nachomcapella/Upper-Limb-Rehabilitation-Interface-with-Arduino/second-version/documents-images/diagrama_electronica-v2.2.jpg

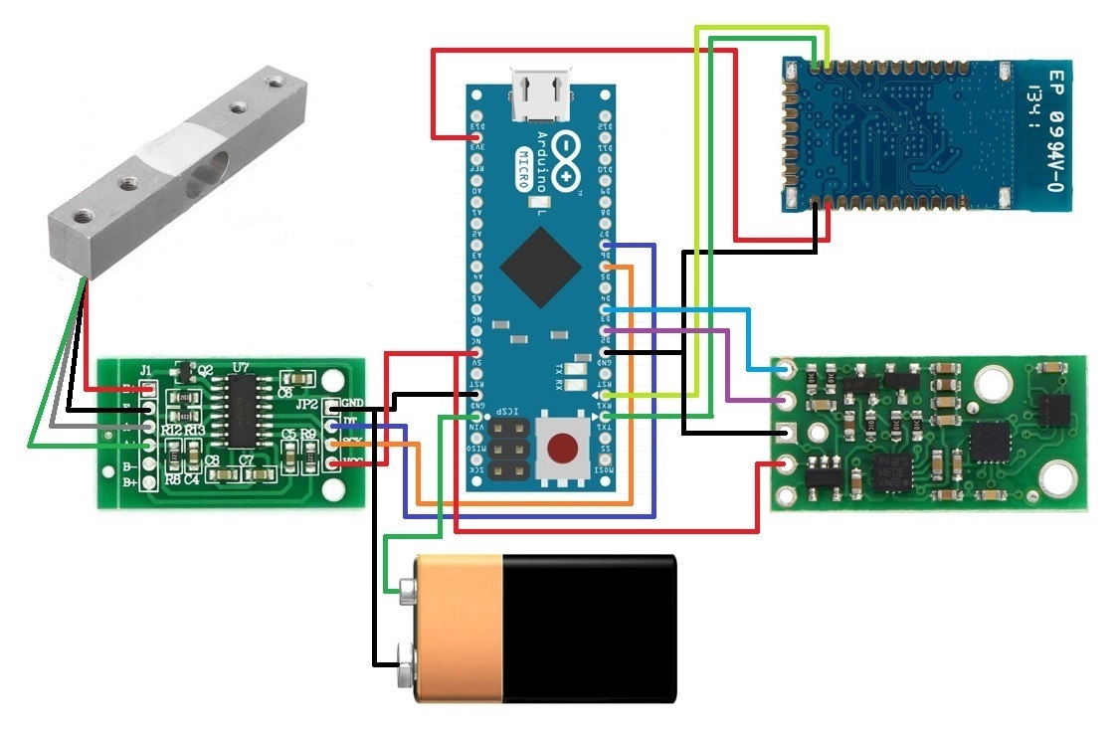
second-version/documents-images/diagrama_electronica-v2.2.jpg
