nachomcapella/Upper-Limb-Rehabilitation-Interface-with-Arduino/README.md

# upper-limb-rehabilitation-arduino
This repository includes the code employed for the construction of an interface oriented to upper limb rehabilitation. Includes Arduino code, squematics and a videogame (flash).
