nachomcapella/Upper-Limb-Rehabilitation-Interface-with-Arduino/second-version/documents-images/ArduinoMicro_Pinout.png

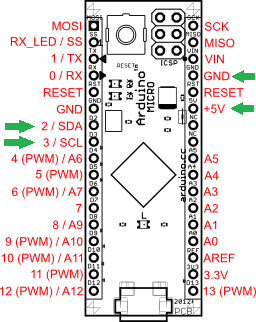
second-version/documents-images/ArduinoMicro_Pinout.png
