nachomcapella/Upper-Limb-Rehabilitation-Interface-with-Arduino/second-version/documents-images/diagrama-hx711-amplificador-arduino.jpg

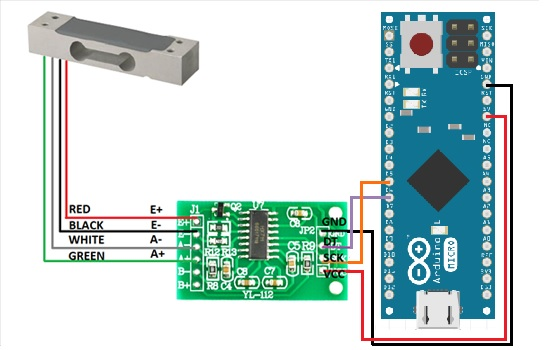
second-version/documents-images/diagrama-hx711-amplificador-arduino.jpg
