nachomcapella/Upper-Limb-Rehabilitation-Interface-with-Arduino/second-version/documents-images/diagrama_electronica_primer_modelo_bluetooth.jpg

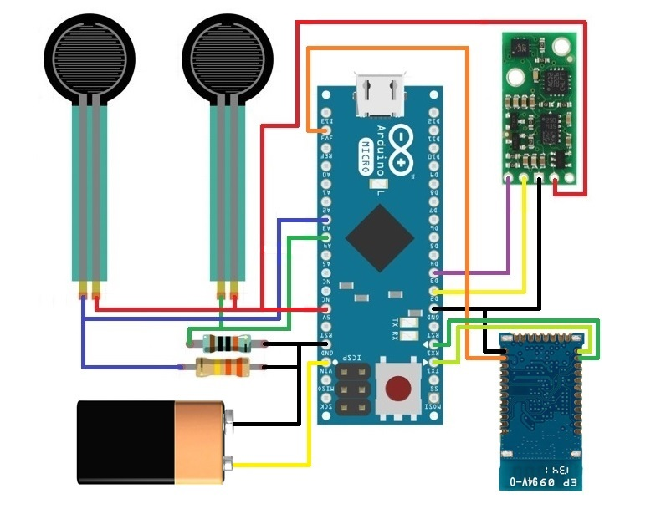
second-version/documents-images/diagrama_electronica_primer_modelo_bluetooth.jpg
