nachomcapella/Upper-Limb-Rehabilitation-Interface-with-Arduino/second-version/documents-images/interfaz-1-derecha.jpg

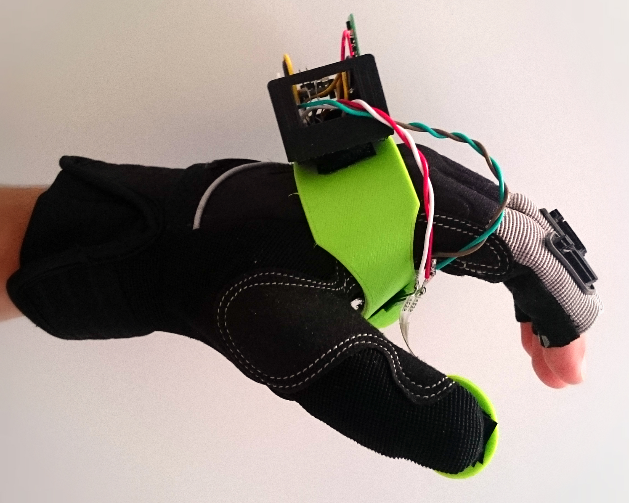
second-version/documents-images/interfaz-1-derecha.jpg
