nachomcapella/Upper-Limb-Rehabilitation-Interface-with-Arduino/second-version/documents-images/interfaz-2-frontal.jpg

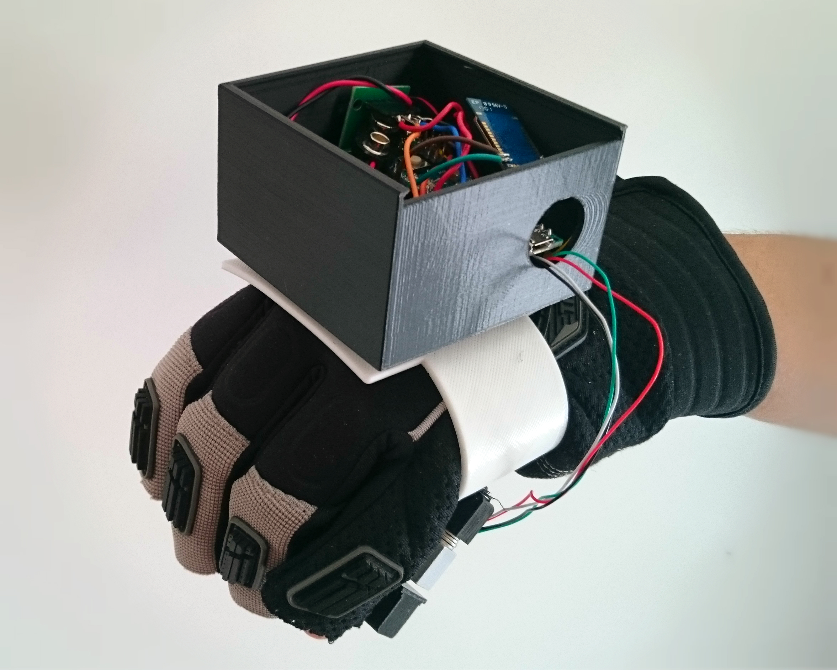
second-version/documents-images/interfaz-2-frontal.jpg
