nachomcapella/Upper-Limb-Rehabilitation-Interface-with-Arduino/second-version/documents-images/interfaz-2-inferior.jpg

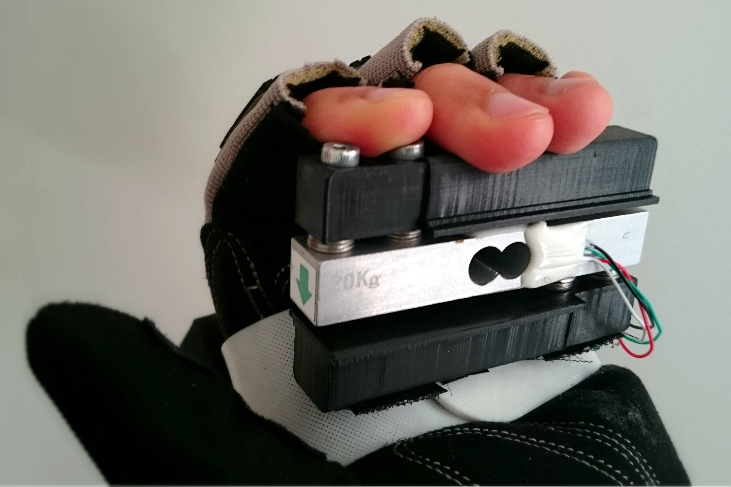
second-version/documents-images/interfaz-2-inferior.jpg
