nachomcapella/Upper-Limb-Rehabilitation-Interface-with-Arduino/second-version/documents-images/interfaz-2-izquierda.jpg

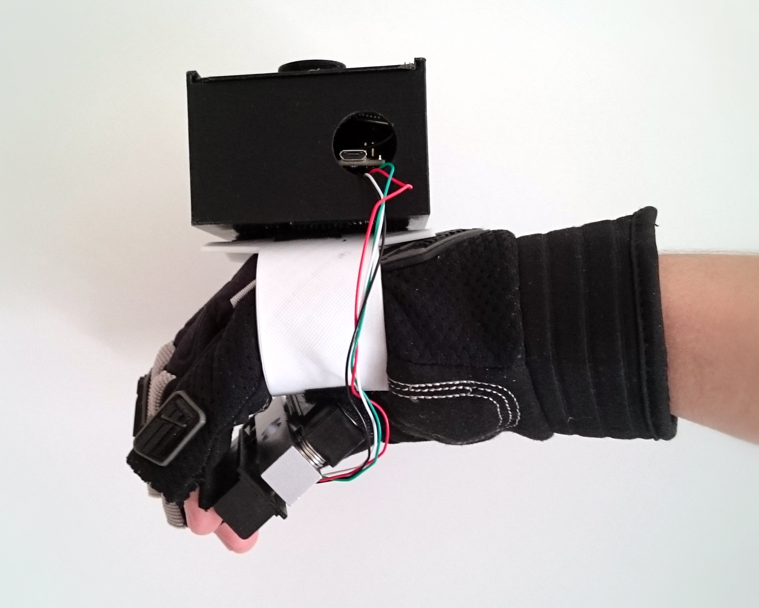
second-version/documents-images/interfaz-2-izquierda.jpg
