nachomcapella/Upper-Limb-Rehabilitation-Interface-with-Arduino/second-version/documents-images/medidas-electronica.png

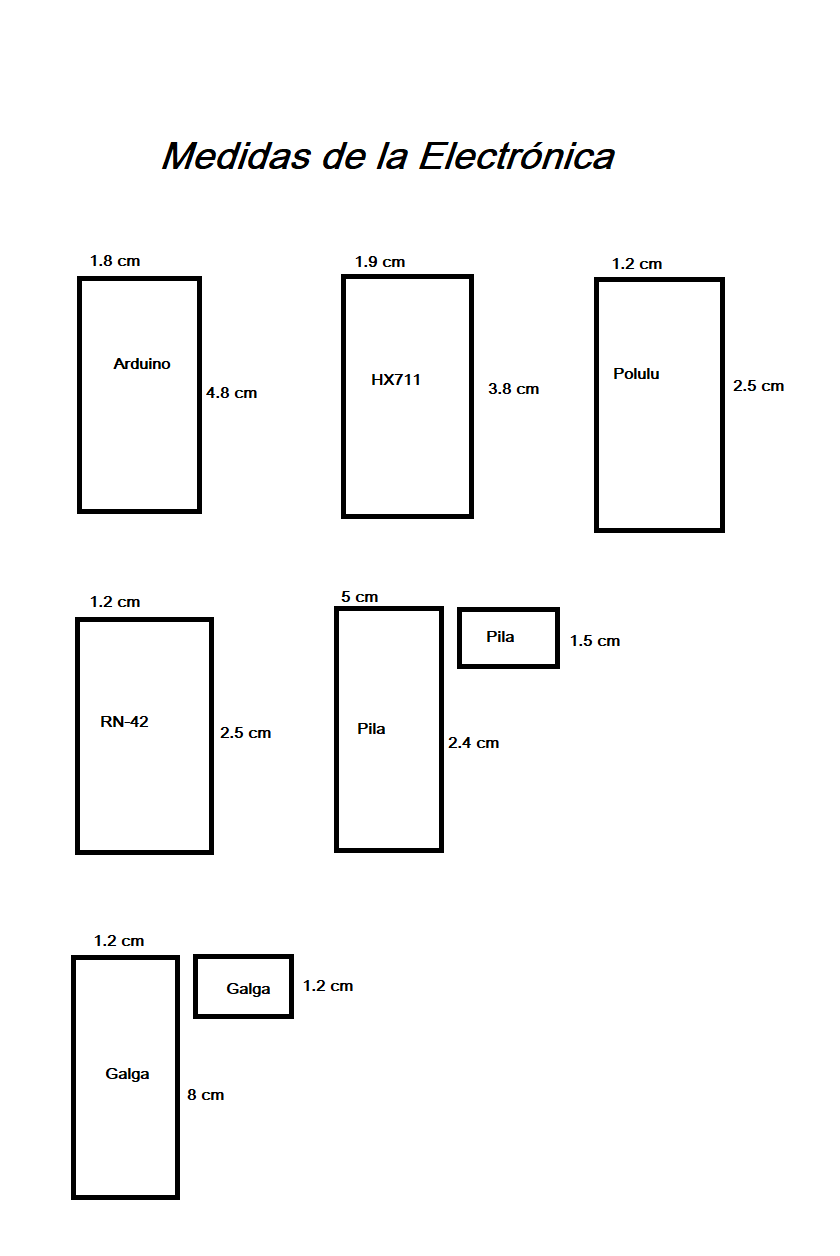
second-version/documents-images/medidas-electronica.png
