nachomcapella/Upper-Limb-Rehabilitation-Interface-with-Arduino/second-version/documents-images/monitor-serie-2.JPG

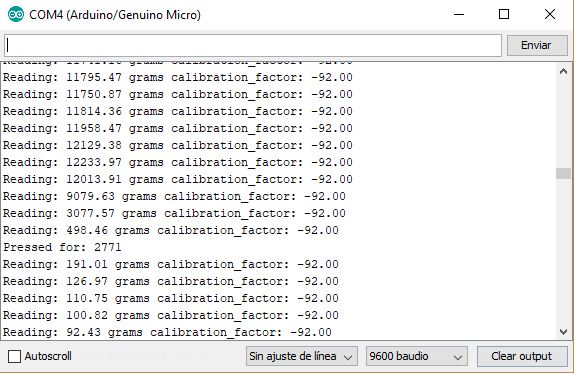
second-version/documents-images/monitor-serie-2.JPG
