nachomcapella/Upper-Limb-Rehabilitation-Interface-with-Arduino/second-version/documents-images/temperature-plot.png

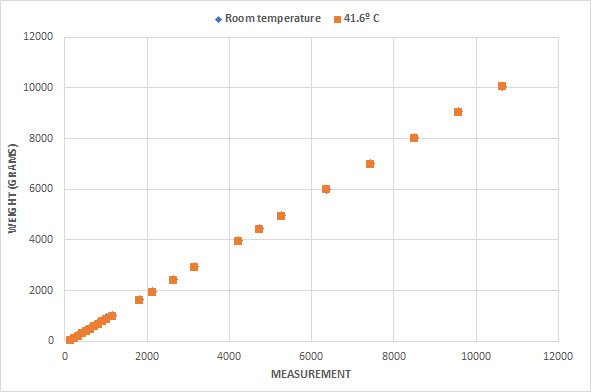
second-version/documents-images/temperature-plot.png
