nachomcapella/Upper-Limb-Rehabilitation-Interface-with-Arduino/second-version/documents-images/vista-freecad.PNG

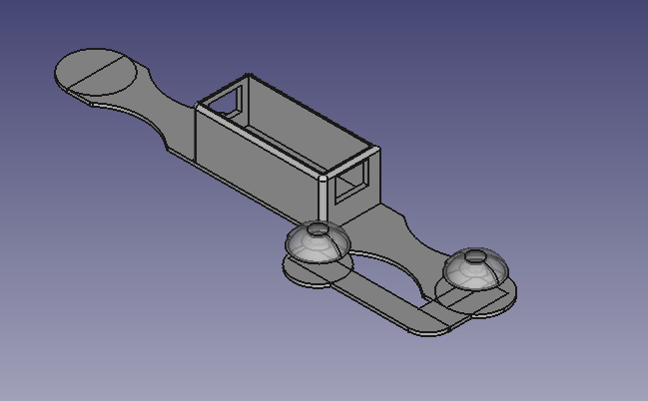
second-version/documents-images/vista-freecad.PNG
