nachomcapella/Upper-Limb-Rehabilitation-Interface-with-Arduino/3d-printing/guante.FCStd

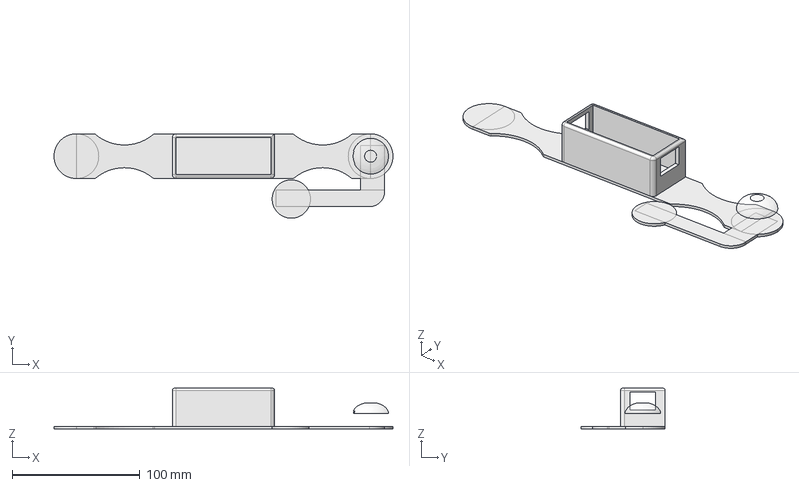
[picture p24: CAD file, 2018-01-18]
3d-printing/guante.FCStd
265.0 x 66.0 x 32.0 mm
Correa
Boton001
Caja002
Boton003
