nachomcapella/Upper-Limb-Rehabilitation-Interface-with-Arduino/second-version/3d-printing/pera3.FCStd

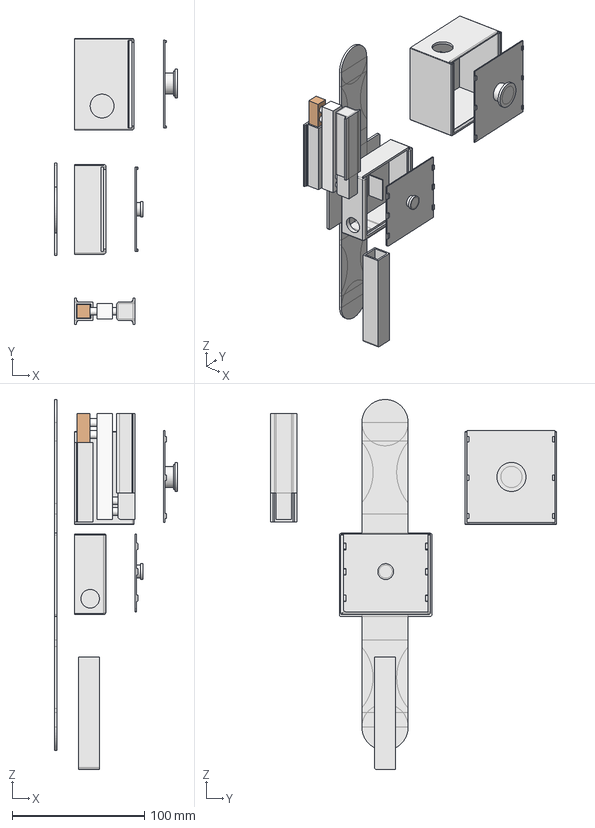
[picture p25: CAD file, 2018-07-01]
second-version/3d-printing/pera3.FCStd
93.0 x 216.0 x 279.5 mm
Cubo038
