nachomcapella/Upper-Limb-Rehabilitation-Interface-with-Arduino/second-version/documents-images/hx711-calibracion-v3.xlsx

Arroz (gr) | Medida | Factor de corrección | Factor de corrección | Masa | Medida (T ambiente) | Medida (41.6ºC) |  |  |  | Masa | Medida 1 | Medida 2 | Medida 3 | Medida 4 | Medida 5 | Medida 6 | DesvEstRel | DesvEstRelProm
124 | 124 | -81 | -96 | 110 | 110 | 47 |  |  |  | 2100 | 2103 | 2100 | 2097 | 2097 | 2102 | 2099 | 0.0010883719 | 0.0004527900782
150 | 153 |  |  | 200 | 190 | 133 |  |  |  | 4200 | 4204 | 4202 | 4199 | 4201 | 4203 | 4202 | 0.0003742009889
180 | 189 |  |  | 300 | 285 | 235 |  |  |  | 5260 | 5265 | 5263 | 5261 | 5261 | 5264 | 5263 | 0.0002778910089
201 | 212 |  |  | 400 | 387 | 328 |  |  |  | 6320 | 6323 | 6321 | 6318 | 6318 | 6323 | 6320 | 0.0003261692608
220 | 235 |  |  | 500 | 485 | 414 |  |  |  | 7380 | 7383 | 7380 | 7377 | 7377 | 7381 | 7379 | 0.0002901107252
241 | 258 |  |  | 600 | 581 | 505 |  |  |  | 8440 | 8438 | 8439 | 8433 | 8433 | 8439 | 8432 | 0.0003599965851
260 | 281 |  |  | 700 | 664 | 608
280 | 304 |  |  | 800 | 760 | 702 | Factor de corrección | Masa | Medida | Error | Error^2 | Rows | Rows^2 | E(Error^2)
300 | 324 |  |  | 900 | 858 | 802 | -92 | 2100 | 2103 | -3 | 9 | 2103 | 4422609 | 352
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
