nachomcapella/Upper-Limb-Rehabilitation-Interface-with-Arduino/second-version/documents-images/six-measurements.JPG

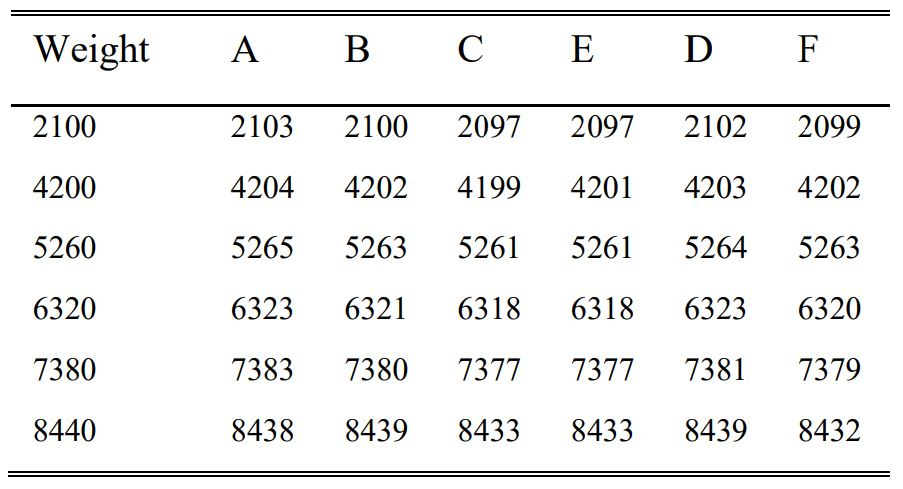
second-version/documents-images/six-measurements.JPG
