nachomcapella/Upper-Limb-Rehabilitation-Interface-with-Arduino/(notices)

Notices in the files:
second-version/arduino/giroscopio-rn42-hx711-definitivo/main/main.ino:
under the terms of the GNU Lesser General Public License as published by the
Free Software Foundation, either version 3 of the License, or (at your option)
